extsui/Valve/Circuit/TTL-232R-3V3.png

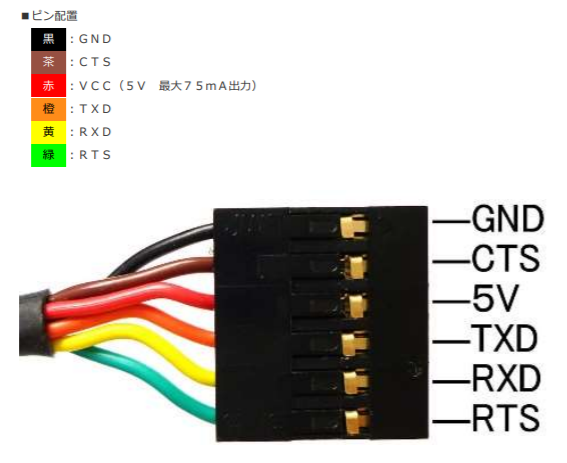
Circuit/TTL-232R-3V3.png
