extsui/Valve/Document/Images/00_フルカラー_クリックタイプ_全速力回転.png

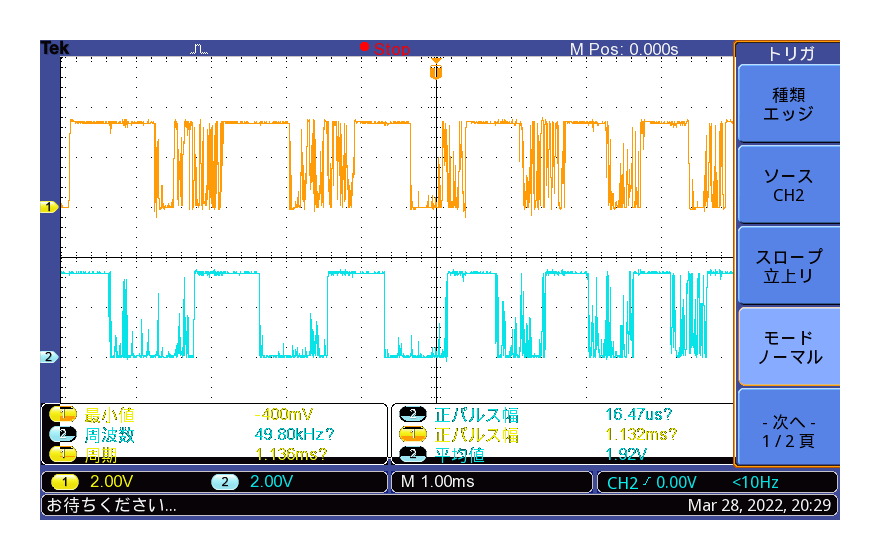
Document/Images/00_フルカラー_クリックタイプ_全速力回転.png
