extsui/Valve/Document/Images/01_フルカラー_クリックタイプ_超低速回転.png

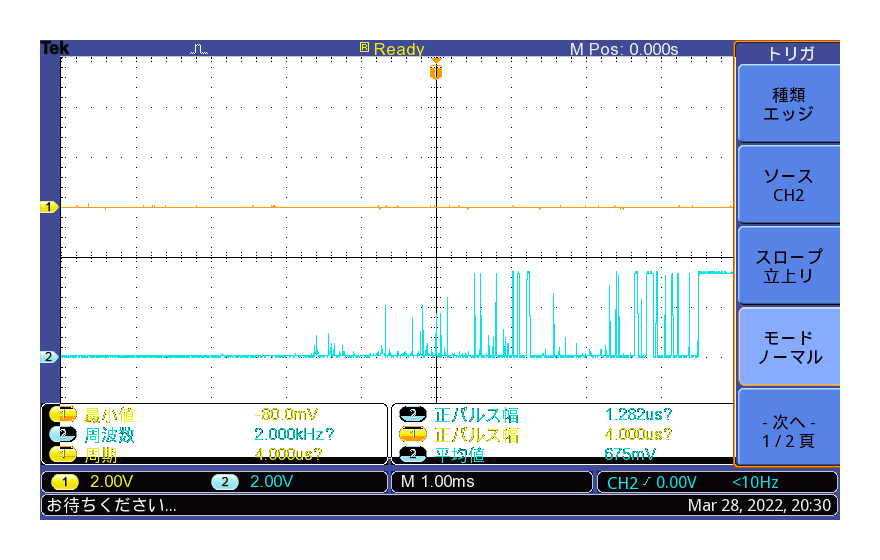
Document/Images/01_フルカラー_クリックタイプ_超低速回転.png
