extsui/Valve/Document/Images/02_フルカラー_クリックタイプ_通常速度回転.png

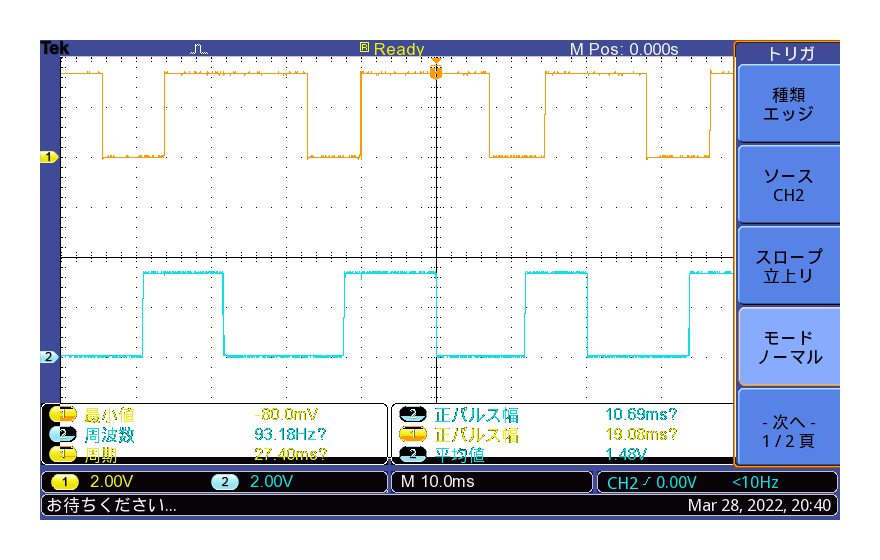
Document/Images/02_フルカラー_クリックタイプ_通常速度回転.png
