extsui/Valve/Document/Images/10_シンプル_クリックタイプ_全速力回転.png

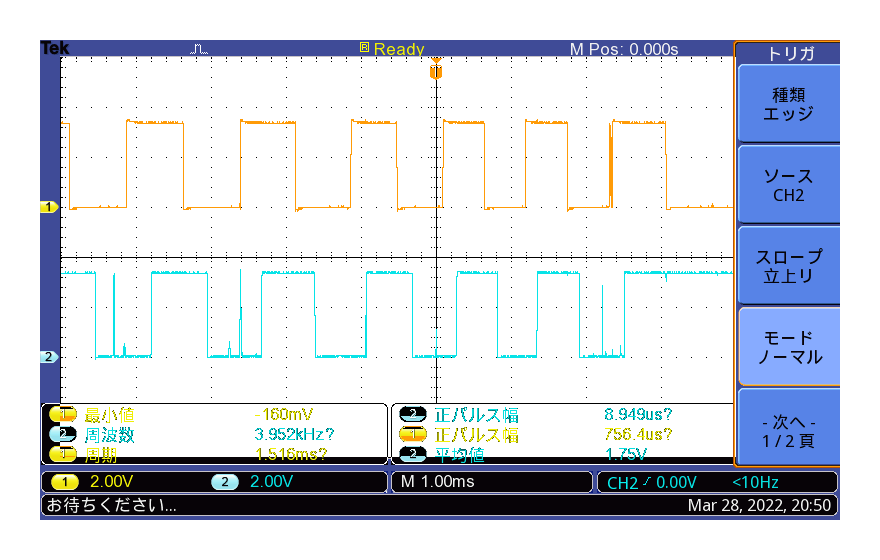
Document/Images/10_シンプル_クリックタイプ_全速力回転.png
