extsui/Valve/Document/Images/12_シンプル_クリックタイプ_通常速度回転.png

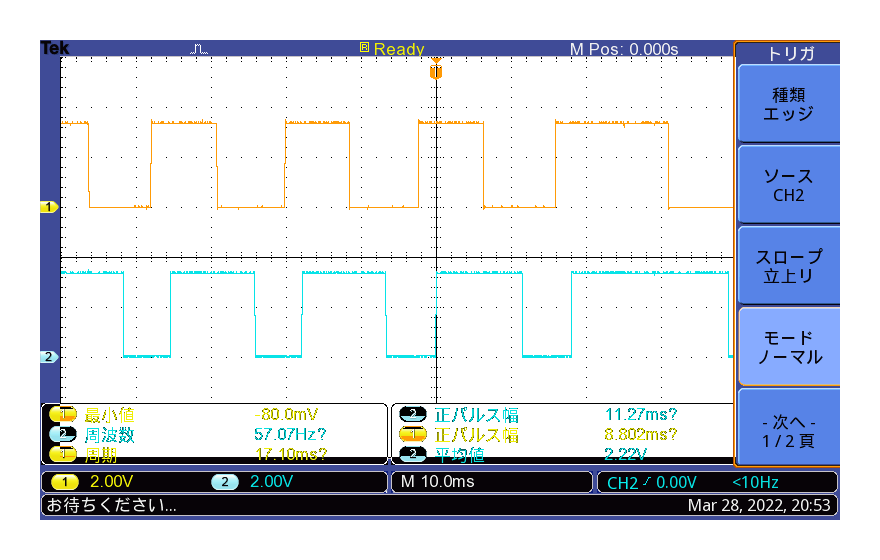
Document/Images/12_シンプル_クリックタイプ_通常速度回転.png
