extsui/Valve/Document/Images/20_シンプル_ノンクリックタイプ_全速力回転.png

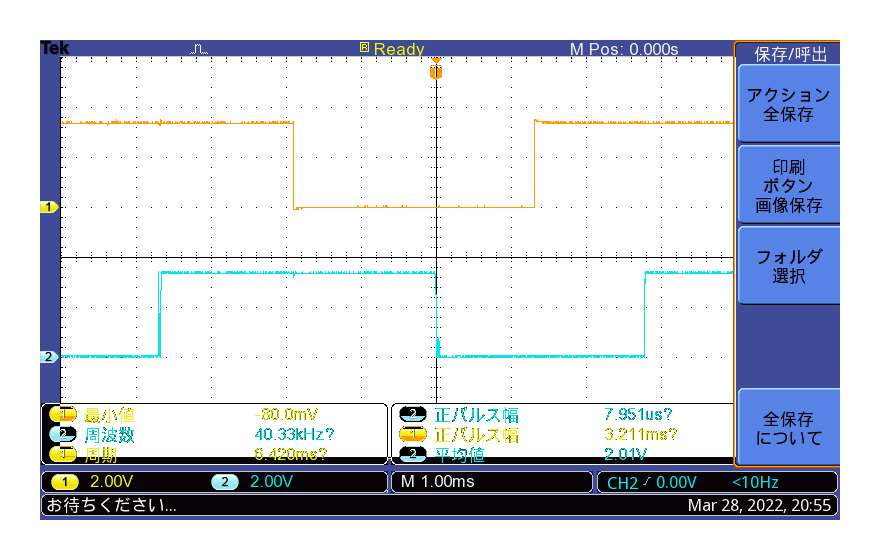
Document/Images/20_シンプル_ノンクリックタイプ_全速力回転.png
