extsui/Valve/Document/Images/21_シンプル_ノンクリックタイプ_低速回転1.png

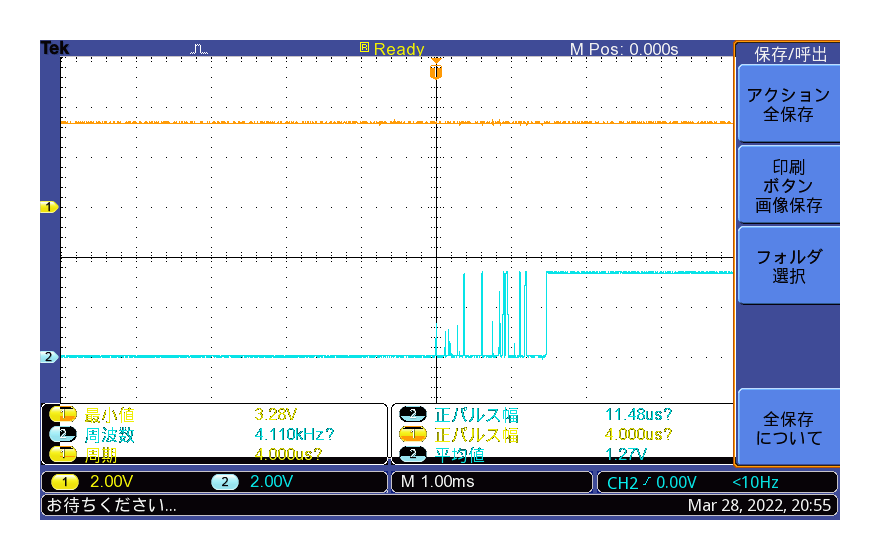
Document/Images/21_シンプル_ノンクリックタイプ_低速回転1.png
