extsui/Valve/(threads)

Thread 1 (2022-03-12):

Valve で操作したエンコーダ以外の値が変化する症状が発生する

extsui, 2022-03-12:
# 再現手順

1. #4 のロータリーエンコーダを操作する（値が10になったとする）
2. #3 のロータリーエンコーダを + 方向に1だけ操作する
3. #3 の値は 0 から変化せず、#4 の値が 11 になる
4. #3 を + 方向に 1 だけ操作する
5. #3 の値が 1 になる

他のチャンネルでも同様の症状が発生する。
また、- 方向に操作した場合は #n+1 のエンコーダの値が 1 回だけ減少する。

extsui, 2022-03-12:
この症状 (不具合) は、#n+1 に影響するのではなく、直前に操作したエンコーダが対象になっていそう。
例：#2 を操作したあとに #4 を操作すると、1回だけ #2 の値が更新される

extsui, 2022-03-24:
同じチャンネルに対する逆操作でも発生していることが発覚。
例：#n を + 方向に操作して 0-->10 にして、#n を - 方向に操作すると 11 になった後に減少を始める。

明らかに FW のロータリエンコーダ管理クラスに不具合がある。

extsui, 2022-03-26:
正確な原因は不明だが e905837 で解消したのでクローズ。

Closed 2022-03-26.

Thread 3 (2022-03-25):

Valve から取得できる値の値域を変更する

extsui, 2022-03-25:
ロータリーエンコーダはボタンと同様に、上位から定期的にポーリングされるという認識なので、取得できる値は int8_t で問題ない。
- 理由1：カウント値自体に意味は少ないため。（前回からの 差分 +/- が重要）
- 理由2：int16_t, int32_t にしたところでオーバーフロー問題は同じなら、通信量の少ない int8_t で良い。

extsui, 2022-03-26:
e9058371c0 で同時に int32_t から int8_t に変更したのでクローズ。

Closed 2022-03-26.

Thread 5 (2022-04-29):

I2Cスレーブドライバの不具合解消

extsui, 2022-04-29:
WhoAmI -> SetReverse -> GetEncValue を Delay なしにしたらフリーズする問題が発生中。
SeeeduinoXIAO 側がおかしくなっている可能性もある。

# メモ
- WhoAmI+SetReverse の最小構成を作って検証すべき。
- スレーブ側で受信コールバックが一回多くなっていそう？
  - ListenCpltCb で受信停止にするべき？
  - HAL 内にそういうコードありそうに見えたが
-
