extsui/Valve/Circuit/Valve.kicad_pcb

## KiCad design Circuit/Valve.kicad_pcb (2022-01-15)

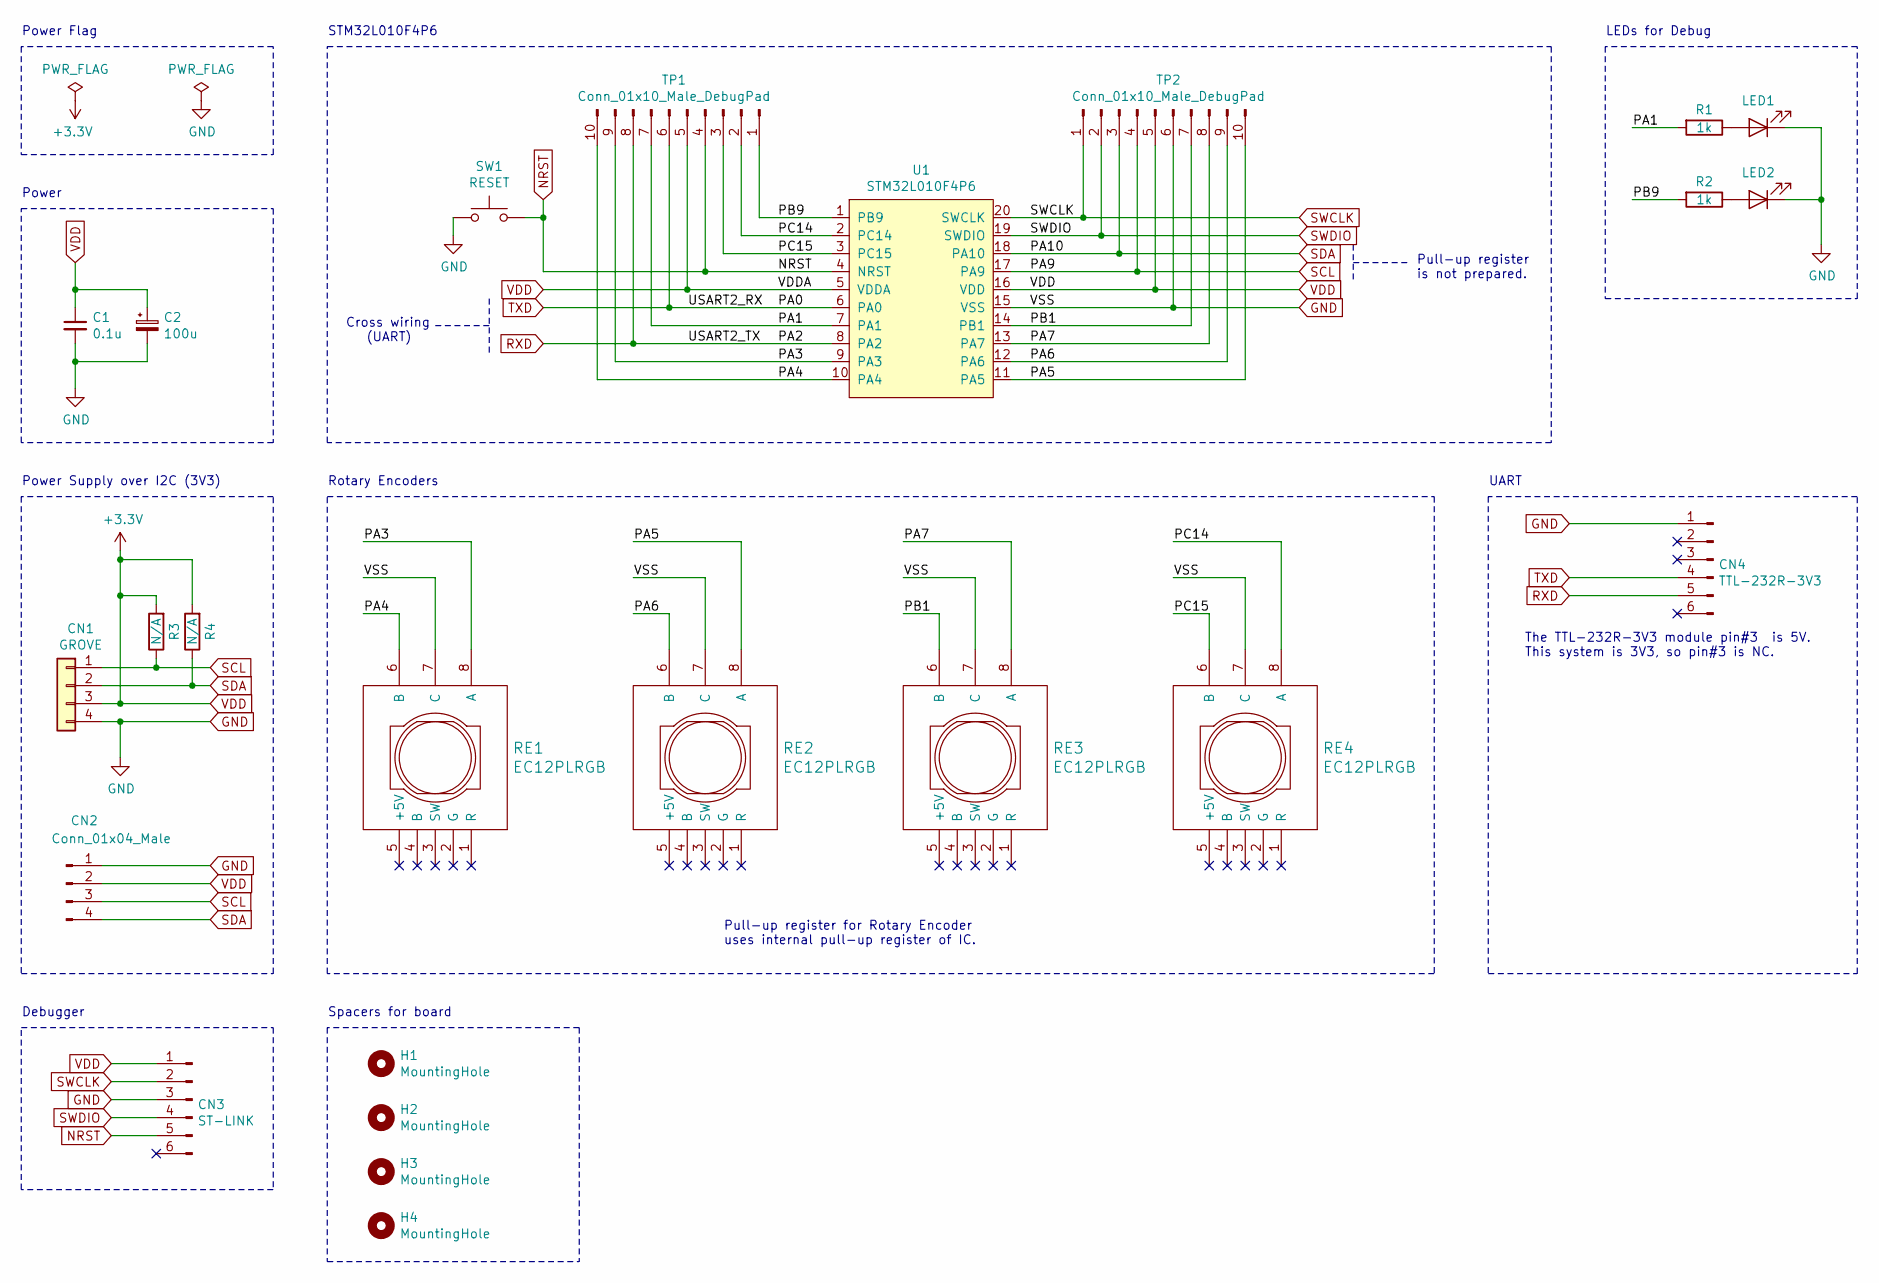
[picture p9: schematic Valve.sch]

Parts:
C1: 0.1u; C_Disc_D5.0mm_W2.5mm_P2.50mm
C2: 100u; CP_Radial_D6.3mm_P2.50mm
CN1: GROVE; HW4-2.0-90D
CN2: Conn_01x04_Male; PinHeader_1x04_P2.54mm_Vertical
CN3: ST-LINK; PinHeader_1x06_P2.54mm_Vertical
CN4: TTL-232R-3V3; PinHeader_1x06_P2.54mm_Vertical
H1, H2, H3, H4: MountingHole; MountingHole_3.2mm_M3
LED1, LED2: LED; LED_D3.0mm
R1, R2: 1k; R_Axial_DIN0207_L6.3mm_D2.5mm_P7.62mm_Horizontal
R3, R4: N/A; R_Axial_DIN0207_L6.3mm_D2.5mm_P7.62mm_Horizontal
RE1, RE2, RE3, RE4: EC12PLRGB
SW1: RESET; SW_PUSH_6mm_H8mm
TP1, TP2: Conn_01x10_Male_DebugPad; PinHeader_1x10_P2.54mm_Vertical
U1: STM32L010F4P6; TSSOP-20_4.4x6.5mm_P0.65mm

Connections:
/PA1: R1.2, TP1.7, U1.7 (PA1)
/PA3: RE1.8 (A), TP1.9, U1.9 (PA3)
/PA4: RE1.6 (B), TP1.10, U1.10 (PA4)
/PA5: RE2.8 (A), TP2.10, U1.11 (PA5)
/PA6: RE2.6 (B), TP2.9, U1.12 (PA6)
/PA7: RE3.8 (A), TP2.8, U1.13 (PA7)
/PB1: RE3.6 (B), TP2.7, U1.14 (PB1)
/PB9: R2.2, TP1.1, U1.1 (PB9)
/PC14: RE4.8 (A), TP1.2, U1.2 (PC14)
/PC15: RE4.6 (B), TP1.3, U1.3 (PC15)
GND: C1.2, C2.2, CN1.4, CN2.1, CN3.3, CN4.1, LED1.1 (K), LED2.1 (K), RE1.7 (C), RE2.7 (C), RE3.7 (C), RE4.7 (C), SW1.1, TP2.6, U1.15 (VSS)
NRST: CN3.5, SW1.2, TP1.4, U1.4 (NRST)
unnamed: LED1.2 (A), R1.1
unnamed: LED2.2 (A), R2.1
RXD: CN4.5, TP1.8, U1.8 (PA2)
SCL: CN1.1, CN2.3, R3.1, TP2.4, U1.17 (PA9)
SDA: CN1.2, CN2.4, R4.1, TP2.3, U1.18 (PA10)
SWCLK: CN3.2, TP2.1, U1.20 (SWCLK)
SWDIO: CN3.4, TP2.2, U1.19 (SWDIO)
TXD: CN4.4, TP1.6, U1.6 (PA0)
VDD: C1.1, C2.1, CN1.3, CN2.2, CN3.1, R3.2, R4.2, TP1.5, TP2.5, U1.5 (VDDA), U1.16 (VDD)

Notes on the sheet:
Cross wiring (UART)
The TTL-232R-3V3 module pin#3 is 5V. This system is 3V3, so pin#3 is NC.
Power Flag
Power Supply over I2C (3V3)
Spacers for board
Pull-up register is not prepared.
Pull-up register for Rotary Encoder uses internal pull-up register of IC.
Debugger
UART
Rotary Encoders
STM32L010F4P6
LEDs for Debug
Power

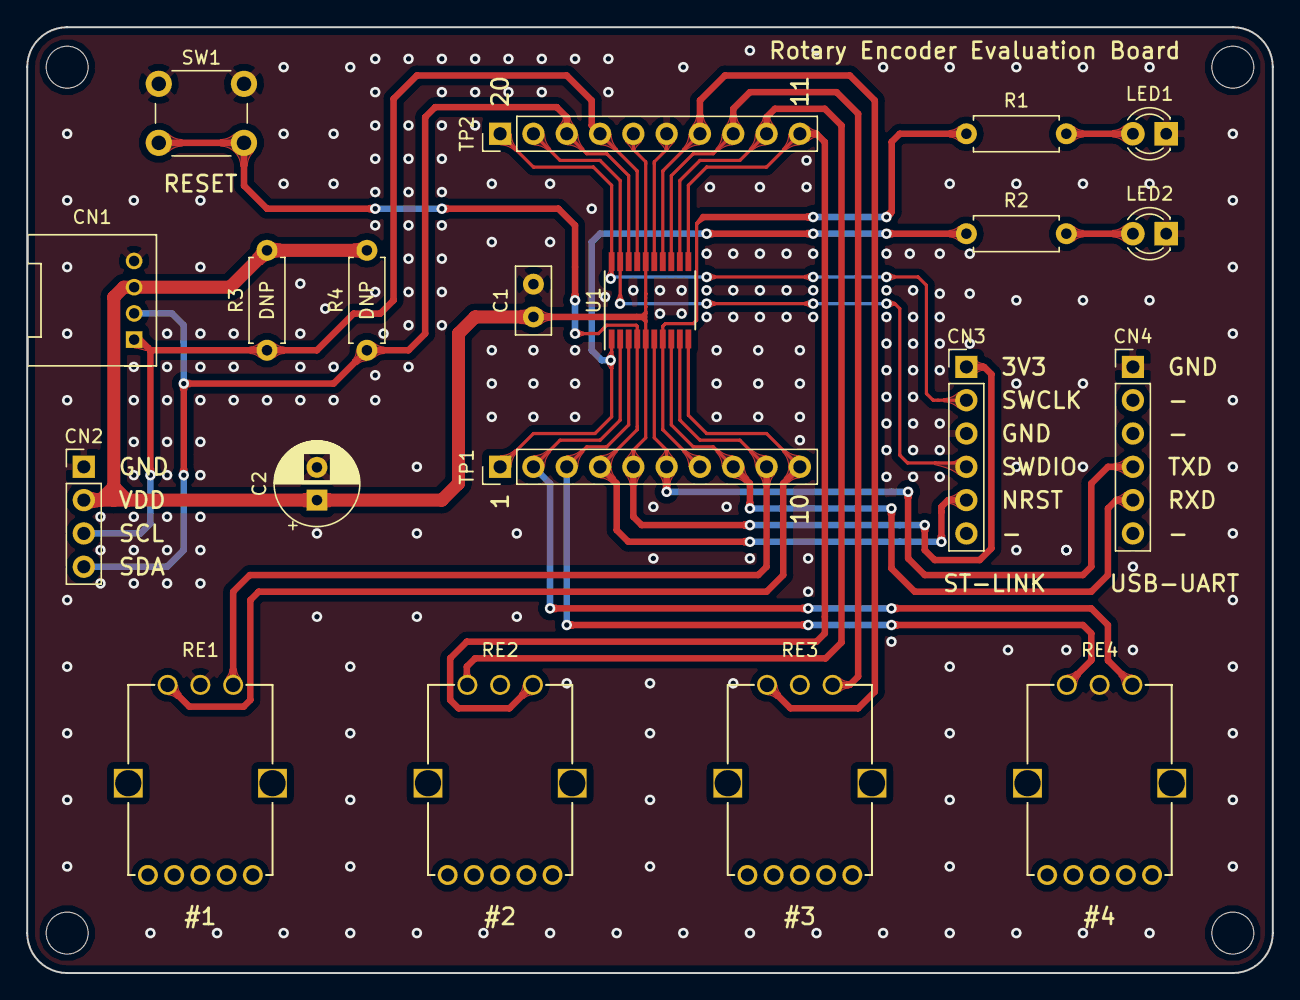
[picture p10: board Valve.kicad_pcb from above]

Board: 2 copper layers, 95.0 x 72.1 mm, 24 parts (0 on the bottom side), 21 nets.
