extsui/Valve/Program/CubeMxGenerated/Valve.ioc

Mcu.UserName=STM32L010F4Px
PA0-CK_IN.Signal=USART2_RX
PA1.GPIO_Label=LED1
PA1.Signal=GPIO_Output
PA10.Signal=I2C1_SDA
PA13.Signal=SYS_SWDIO
PA14.Signal=SYS_SWCLK
PA2.Signal=USART2_TX
PA3.GPIO_Label=RotaryEncoder1A
PA3.Signal=GPIO_Input
PA4.GPIO_Label=RotaryEncoder1B
PA4.Signal=GPIO_Input
PA5.GPIO_Label=RotaryEncoder2A
PA5.Signal=GPIO_Input
PA6.GPIO_Label=RotaryEncoder2B
PA6.Signal=GPIO_Input
PA7.GPIO_Label=RotaryEncoder3A
PA7.Signal=GPIO_Input
PA9.Signal=I2C1_SCL
PB1.GPIO_Label=RotaryEncoder3B
PB1.Signal=GPIO_Input
PC14-OSC32_IN.GPIO_Label=RotaryEncoder4A
PC14-OSC32_IN.Signal=GPIO_Input
PC15-OSC32_OUT.GPIO_Label=RotaryEncoder4B
PC15-OSC32_OUT.Signal=GPIO_Input
