extsui/Valve/(commit log)

2021-12-20 KiCad のベースプロジェクトを登録
    [Valve.kicad_pcb, Valve.sch]
2021-12-24 回路図第一版の作成
    [Valve.kicad_pcb]
2021-12-24 フットプリントの関連付け
    [Valve.sch]
2021-12-29 PCB 部品仮置き
2022-01-04 回路図を修正
    * 電源コネクタ (2P) を I2C 兼用 4P に変更
    * I2C ADDR パッドを削除して LED と抵抗に置換
    [Valve.kicad_pcb, Valve.sch]
2022-01-06 フットプリントにB基板外形を記載
    [Valve.kicad_pcb]
2022-01-06 B基板外形状に部品仮置き
    [Valve.kicad_pcb]
2022-01-07 フットプリントに説明シルクを追加
    [Valve.kicad_pcb]
2022-01-07 I2C プルアップ抵抗 (DNP) を追加
    [Valve.kicad_pcb, Valve.sch]
2022-01-08 配線の全体仮組み
    [Valve.kicad_pcb]
2022-01-11 配線を一通り接続完了
    [Valve.kicad_pcb]
2022-01-11 U1 と TP1,2 間の配線を微細化
    [Valve.kicad_pcb]
2022-01-12 斜め配線を削減して水平垂直配線に変換
    [Valve.kicad_pcb]
2022-01-14 SWD に GND ガードを追加
    [Valve.kicad_pcb]
2022-01-14 R1 用配線を SWD の上側を通すように修正
    [Valve.kicad_pcb]
2022-01-14 I2C に GND ガードを追加
    [Valve.kicad_pcb]
2022-01-15 GND ビア打ちとティアドロップ設定
    [Valve.kicad_pcb]
2022-01-16 v1.0 のガーバーを作成
    [Valve-B.Cu.gbl, Valve-B.Mask.gbs, Valve-B.Paste.gbp, Valve-B.SilkS.gbo, Valve-Edge.Cuts.gm1, Valve-F.Cu.gtl, Valve-F.Mask.gts, Valve-F.Paste.gtp]
2022-01-17 Sample のテンプレを作成
2022-01-17 Valve ライブラリの試作 (動作未確認)
2022-01-18 Valve.Initialize() で疎通確認をするように修正
2022-03-05 MDK-ARM 生成物を追跡対象外に設定
2022-03-05 プログラムのベースプロジェクトを作成
2022-03-05 試作時のコードをポーティング
2022-03-05 vscode にインクルードパス設定ファイルを追加
2022-03-07 ロータリーエンコーダ動作で LED1 をトグルするように修正
2022-03-07 (ValveDemo) VisualStudioベースプロジェクトを作成
2022-03-08 (ValveDemo) OxyPlot をインストール
2022-03-13 (ValveDemo) GUI レイアウト仮決め
2022-03-13 (ValveDemo) COM ポート接続/切断を実装
2022-03-13 (ValveDemo) 送受信ログが自動スクロールされるように修正
2022-03-13 (ValveDemo) 送信ログを削除してデバッグログに転用
2022-03-13 (ValveDemo) Valve データ構造を追加
2022-03-13 (ValveDemo) スライダが連動するように修正
2022-03-14 (ValveDemo) エンコーダの値をスライダーの下に表示するように修正
2022-03-24 (ValveDemo) 受信ログが重たかったので ListBox に変更して軽量化
2022-03-25 (ValveDemo) Valve のキューを追加
2022-03-25 (ValveDemo) Encoder#1 のデータをグラフに連動
2022-03-25 (ValveDemo) 全ての Encoder をグラフに連動
2022-03-26 (Valve) 操作方向と逆に値が変化する不具合の解消 #1
    * 正確な原因は不明
    * 積算位置と差分反映のタイミングのズレが原因の可能性あり
    * Get()&Commit() の構造を単純化して Get() のみに変更して解決
2022-03-26 (ValveDemo) スライドバーの値域修正と操作不可能化
2022-03-26 (ValveDemo) タイムスタンプをグラフのX軸として使用するように修正
2022-03-26 (ValveDemo) グラフをリアルタイム描画に修正
    * X軸の時間範囲を追従
    * チェックボックスと各エンコーダの線グラフを連動
2022-03-26 (ValveDemo) グラフのサイズ調整と各エンコーダの色で連動を表現
2022-03-27 (ValveDemo) 受信ログ (ListBox) の自動スクロールを実装
2022-03-27 (ValveDemo) グラフ描画のリファクタリング
2022-03-27 (Valve) ロータリエンコーダに逆向き設定機能を追加 #2
2022-03-28 ロータリエンコーダの波形画像を追加
2022-04-13 (Valve) HAL_I2C を有効化
    * ビルドオプションが -O0 だと ROM に収まらなかったので -O2 に変更
2022-04-13 (Valve) I2C 受信データ解析と送信データ構築をメインコンテキストで行うように修正
2022-04-16 (Valve) I2C テスト用のデータ送信サンプルを作成
2022-04-17 (Valve) I2C 受信解析ハンドラを作成
2022-04-17 (Valve) I2C コマンドの全テストを追加
2022-04-17 (ValveDemo) C# で USB-CDC 経由のみシリアル受信ができない不具合を修正
2022-04-17 (Valve) 正転逆転を外部から指定可能に変更
2022-04-17 (ValveSample) XIAO USB-CDC 経由での ValveDemo 繋ぎこみ
2022-04-17 (Valve) デバッガの SWD クロックを 4MHz に修正
2022-04-19 (Valve) I2C スレーブドライバをメインから分離して整理
2022-04-19 ValveDemo のデモ動画を追加
2022-04-20 (Valve) ROM 削減のために TIM2 周期タイマを SysTick で置き換え
    * 約 1KiB の削減
2022-04-20 (Valve) I2C スレーブドライバに初期化アサートを追加
2022-04-20 (Valve) I2C スレーブドライバの受信コールバックを割り込みコンテキストに移動
